MakersFunDuck/Ducky-Board-ESP32-S3/schematics.pdf

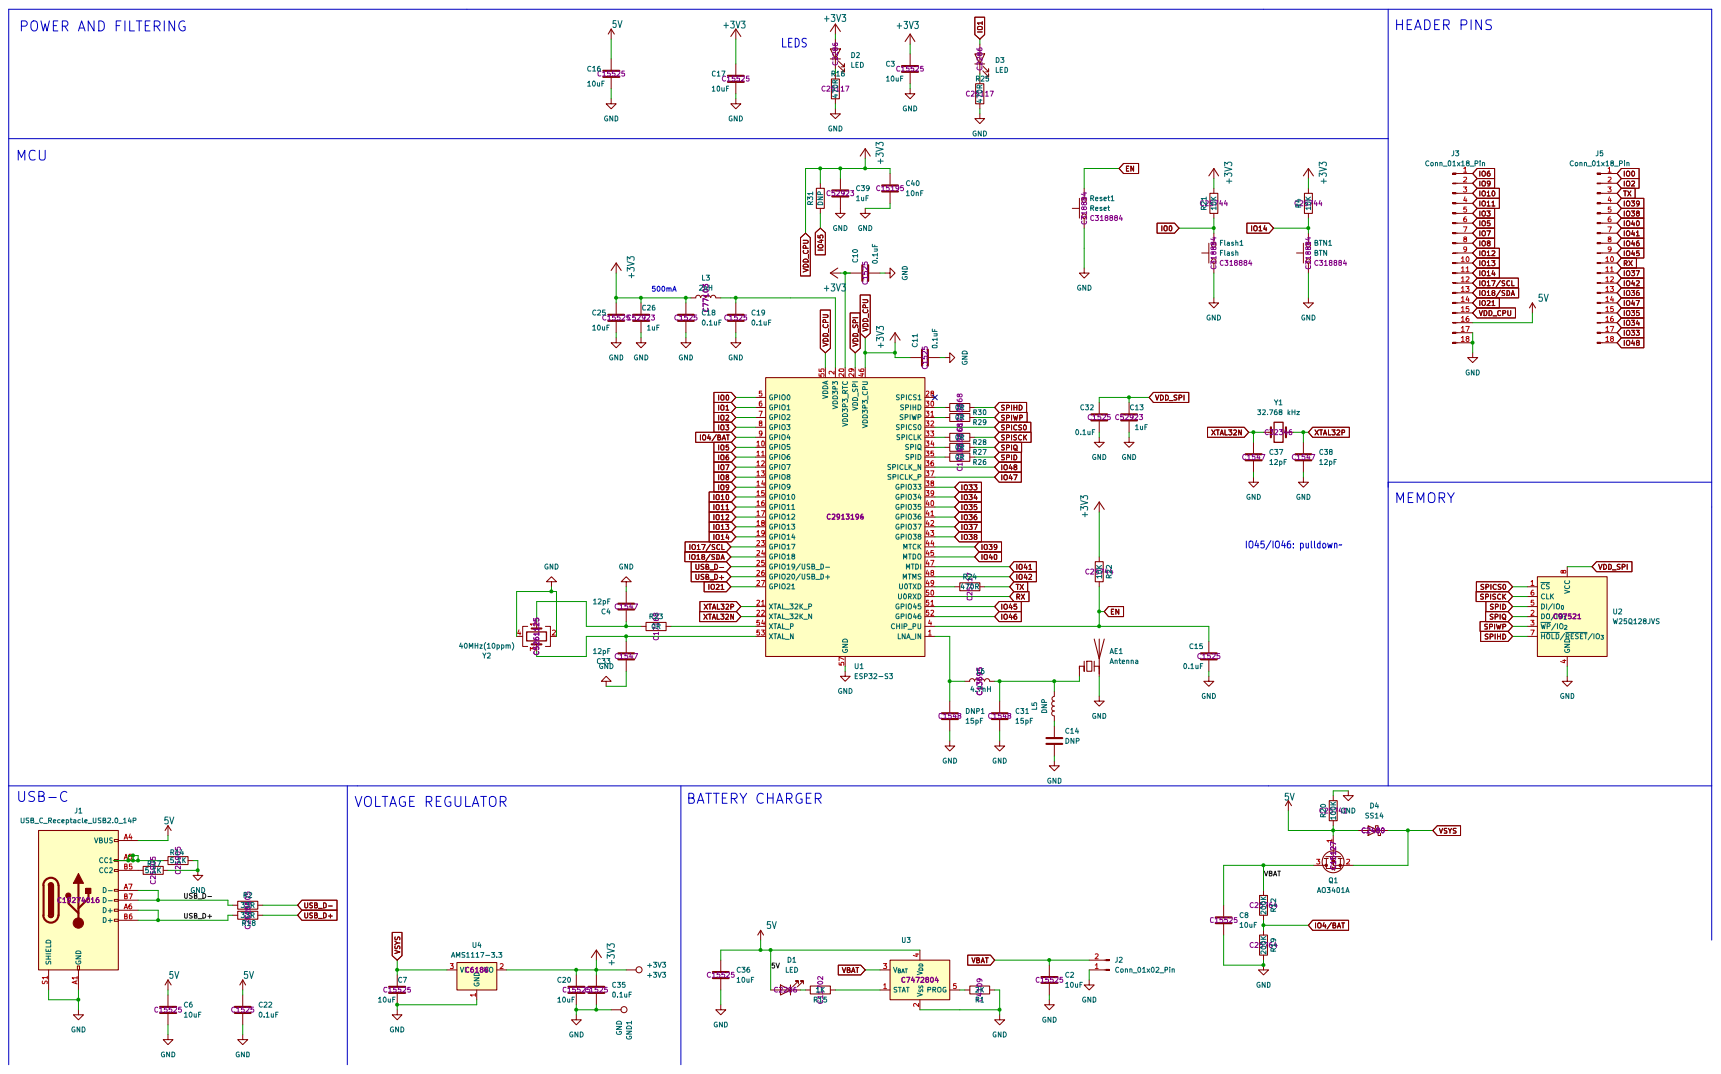
[picture p2: page 1]
