MakersFunDuck/Ducky-Board-ESP32-S3/(threads)

Thread 1 (2025-05-10):

WiFi Performance

Pablojosep, 2025-05-10:
Hi There,

Just want to ask you about your pcb antenna, I see it may be based in the espressif board guideliness, besides that i was wondering how did you select the filter for the antena? Is it working fine? nice range?

Pablojosep, 2025-07-14:
I tried to calculate the impedance for a PI filter and that was a complete failure without the help of a VFA so I decided to follow the Recomended values described in the RF section in the espressif's ESP32-S3 Hardware Design Guidelines. I may say i kept my transmission line in the PCB at 50 Ohms and that worked wonders.

[esp-hardware-design-guidelines-en-master-esp32s3.pdf](https://github.com/user-attachments/files/21211949/esp-hardware-design-guidelines-en-master-esp32s3.pdf)
